hishamcse/Physical-Feedback-Based-Smart-Stick-For-Blind-People/(list of files, drawings)

Other design files:
Diagram & CKT/Final CKT.pdsprj
