hishamcse/Physical-Feedback-Based-Smart-Stick-For-Blind-People/(commit log)

2022-09-02 Circuit Diagram and Proteus Circuit Added
    [Final CKT.pdsprj]
2022-09-02 Testing Modules & Sensors
